sseungh/6-Legged/Hardware/6_hw.jpg

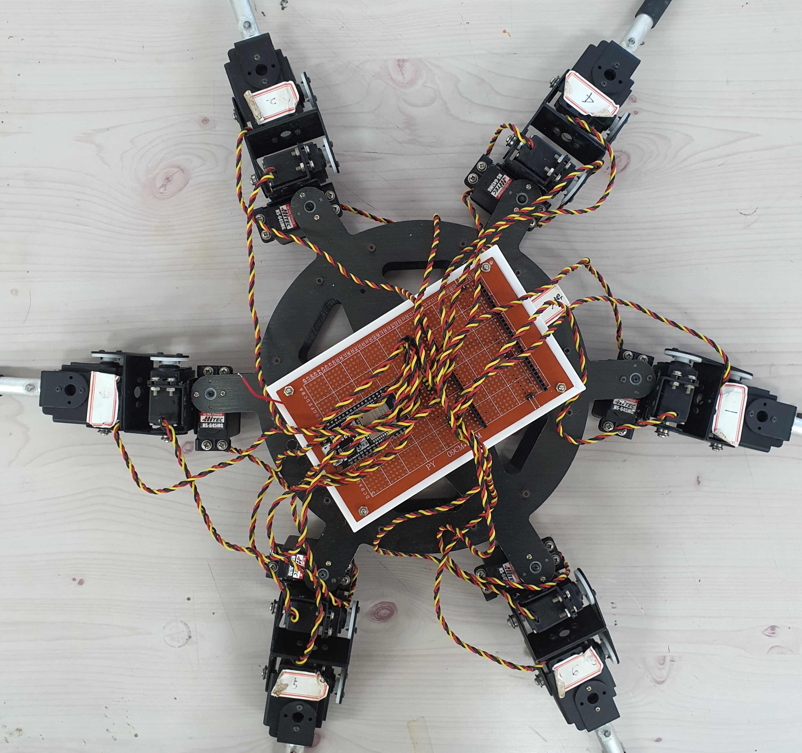
Hardware/6_hw.jpg
