sseungh/6-Legged/Hardware/6_boxModel.stl

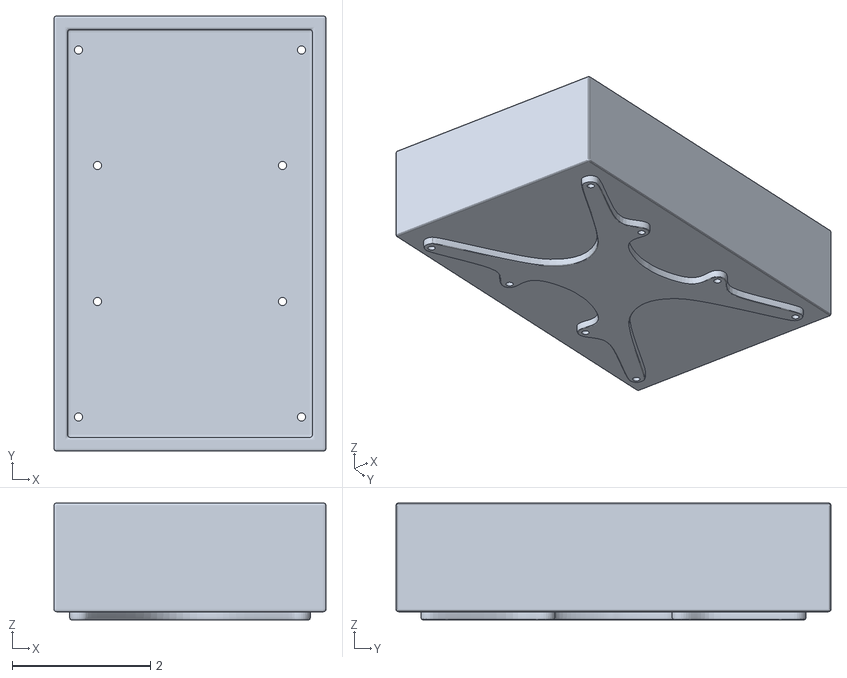
[picture p11: CAD file, 2022-12-14]
Hardware/6_boxModel.stl
3.94 x 6.30 x 1.69
