sseungh/6-Legged/Codes/_esp32s3_test_0/_esp32s3_test_0.ino

/*
  Controls servo position from 0-180 degrees and back
  https://wokwi.com/projects/350037178957431378
  by dlloydev, December 2022.
*/

#include <pwmWrite.h>

Pwm pwm = Pwm();

const int servoPin = 2;
int pos = 0;

void setup() {
}

void loop() {
  for (pos = 0; pos <= 180; pos++) {  // go from 0-180 degrees
    pwm.writeServo(servoPin, pos);    // set the servo position (degrees)
    delay(25);
  }
  for (pos = 180; pos >= 0; pos--) {  // go from 180-0 degrees
    pwm.writeServo(servoPin, pos);    // set the servo position (degrees)
    delay(25);
  }
}
